davisreinaguerra/Monster_Task/matlab_control/run.png

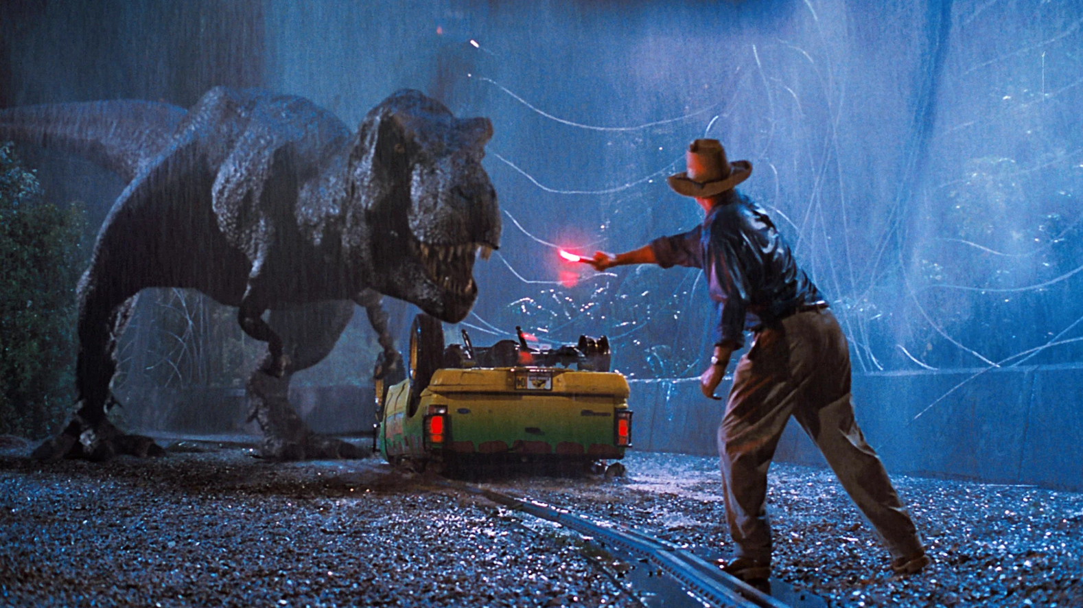
matlab_control/run.png
