davisreinaguerra/Monster_Task/arduino_main/README.md

### Initialization Code

```c++
//______________ Custom Classes_____________________
#include "lick_sensor.h"
#include "solenoid.h"
#include "alignment.h"
#include "IR_sensor.h"

//_______________ Door Servo Setup _________________
#include <Servo.h>
Servo doorServo;
#define door_open_pos 85
#define door_closed_pos 180

// _______________LCD Display_______________________
#include <LiquidCrystal_I2C.h>
LiquidCrystal_I2C lcd(0x27,20,4);

// ____________Variable Initializations_____________
const int flush_volume_delay 2000; // ms
long int delay_between_lick_and_deliver 50;
int current_trial = 0;
unsigned long start_time;
unsigned long lick_time;  
int state;
bool ready_to_begin = false;

  // Session config
long int n_trials;
long int intertrial_interval;
long int enter_time_limit;
long int reward_volume;
long int monster_qm;
long int sound_qm;
long int begin_qm;

//_______________Data Structure____________________
typedef struct {
  // numerical data
  long int trial_duration;
  long int latency_to_enter;
  long int latency_to_trigger;
  long int latency_to_lick;
  long int escape_duration;
  // logical data  
  bool mouse_entered = false;
  bool threat_triggered = false;
  bool port_licked = false;
} monster_session;

monster_session trial[n_trials];

//_______________Pin Assignments_____________________
                                          // D0
                                          // D1
IR_sensor nestIR(2);                      // D2
IR_sensor enterIR(3);                     // D3 ~
IR_sensor threatIR(4);                    // D4
#define door_pin 5                        // D5 ~
solenoid reward_port(6);                  // D6 ~
lick_sensor lick(7);                      // D7
#define sound_trigger_pin 8               // D8 
#define threat_trigger_pin 9              // D9 ~
alignment threat_trigger_alignment(10);   // D10 ~
alignment lick_reward_alignment(11);      // D11 ~
alignment start_alignment(12);            // D12
                                          // D13
```

### Void Setup
```c++
void setup() {
  // Open serial port
  Serial.begin(9600);

  // PinModes
  pinMode(threat_trigger_pin, OUTPUT);
  pinMode(sound_trigger_pin, OUTPUT);
  doorServo.attach(door_pin);

  // Initialize LCD screen
  lcd.init();
  lcd.clear();
  lcd.backlight();

  // Configure Session
  lcd_write(0, 0, "Waiting 4 config...");

  n_trials = read_config();
  intertrial_interval = read_config();
  enter_time_limit = read_config();
  reward_volume = read_config();
  monster_qm = read_config();
  sound_qm = read_config();
  begin_qm = read_config();

  // Report Configuration
  lcd_write_2_lines(0, 0, "n_trials: ", 0, 2, String(n_trials));
  lcd_write_2_lines(0, 0, "intertrial_interval (ms): ", 0, 2, String(intertrial_interval));
  lcd_write_2_lines(0, 0, "enter_time_limit (ms): ", 0, 2, String(enter_time_limit));
  lcd_write_2_lines(0, 0, "reward_volume (ms): ", 0, 2, String(reward_volume));

  switch (monster_qm) {
    case 1: 
      lcd_write(0,0,"Monster: ON");
      break;
    case 0:
      lcd_write(0,0,"Monster: OFF");
      break;
  }

  switch (sound_qm) {
    case 1: 
      lcd_write(0,0,"Sound: ON");
      break;
    case 0:
      lcd_write(0,0,"Sound: OFF");
      break;
  }

  switch (begin_qm) {
    case 1: 
      lcd_write(0,0, "Session begun!");
      break;
    case 0:
      while(1);
  }
  
  start_time = millis();
  state = 0;
}
```

### Void Loop
```c++
void loop() {

  if (current_trial > n_trials) {state = 6;}

  switch (state) {
    
    case 0: // Session Begun

      // Do this
      fast_open();
      
      // Check for state switching events
      if (enterIR.is_broken()) {
        state = 1;
        start_alignment.align_offset();
        Serial.println("State Switch -> Mouse Entered State");
        lcd_write("Mouse Entered");
      }
      if ((millis() - start_time) > enter_time_limit) {
        state = 5;
        Serial.println("State Switch -> Trial Ended State");
        lcd_write("Trial ended");
      }
      
      break; 

    case 1: // Mouse Entered

      // Report this
      trial[current_trial].mouse_entered = true;
      trial[current_trial].latency_to_enter = millis() - start_time;

      // Check for state switching events
      if (threatIR.is_broken()) {
        state = 2;
        Serial.println("State Switch -> Threat Triggered State");
        lcd_write("Threat triggered");
      }
      if (nestIR.is_broken()) {
        state = 5;
        Serial.println("State Switch -> Trial Ended State");
        lcd_write("Trial ended");
      }
      
      break;

    case 2: // Threat Triggered

      // Do this
      threat_trigger_alignment.align_onset();
      digitalWrite(threat_trigger_pin, monster_qm);
      digitalWrite(sound_trigger_pin, sound_qm);
      
      // Report this
      trial[current_trial].threat_triggered = true;
      trial[current_trial].latency_to_trigger = millis() - start_time;

      // Check for state switching events
      if (lick.is_licked()) {
        state = 3;
        lick_reward_alignment.align_onset(); 
        Serial.println("State Switch -> Port Licked State");
        lcd_write("Port Licked");
      }
      if (nestIR.is_broken()) {
        state = 5;
        threat_trigger_alignment.align_offset();
        Serial.println("State Switch -> Trial Ended State");
        lcd_write("Trial ended");
      }
      
      break;

    case 3: // Port_licked
            
      lick_time = millis();
  
      // Report this
      trial[current_trial].port_licked = true;
      trial[current_trial].latency_to_lick = millis() - start_time;

      lick_reward_alignment.align_offset();

      // Wait
      delay(delay_between_lick_and_deliver);      

      // Do this
      reward_port.pulse_valve(solenoid_volume_delay);
      lick_reward_alignment.align_onset();

      state = 4;
      Serial.println("State Switch -> Reward Delivered State");
      lcd_write("Reward Delivered");
      lick_reward_alignment.align_offset();

      break;
    
    case 4: // Reward Delivered

      // Check for state switching events
      if (nestIR.is_broken()) {
        trial[current_trial].escape_duration = millis() - lick_time;
        state = 5;
        threat_trigger_alignment.align_offset();
        Serial.println("State Switch -> Trial Ended State");
        lcd_write("Trial ended");
      }

      break;

    case 5: // Trial_ended
      
      // Close the door
      fast_close();
      
      // Report this
      Serial.println("# Trial has ended");
      trial[current_trial].trial_duration = millis() - start_time;

      // display trial outcomes to serial monitor
      Serial.print("Trial = "); Serial.println(current_trial); // Trial Number

      Serial.print("trial_duration = "); Serial.println(trial[current_trial].trial_duration);
      Serial.print("latency_to_enter = "); Serial.println(trial[current_trial].latency_to_enter);
      Serial.print("latency_to_trigger = "); Serial.println(trial[current_trial].latency_to_trigger);
      Serial.print("latency_to_lick = "); Serial.println(trial[current_trial].latency_to_lick);
      Serial.print("escape_duration = "); Serial.println(trial[current_trial].escape_duration);
      Serial.print("mouse_entered = "); Serial.println(trial[current_trial].mouse_entered);
      Serial.print("threat_triggered = "); Serial.println(trial[current_trial].threat_triggered);
      Serial.print("port_licked = "); Serial.println(trial[current_trial].port_licked);

      // Finalize this trial
      digitalWrite(threat_trigger_pin, LOW);
      digitalWrite(sound_trigger_pin, LOW);

      // Wait for the intertrial interval
      delay(intertrial_interval);

      //Move on to next trial
      current_trial += 1;
      state = 0;
      start_alignment.align_onset();
      Serial.println("State Switch -> Session Begun State");
      start_time = millis();
      break;

    case 6: // Session Complete
      Serial.println("Session Complete!");
      fast_close();
      while(1);
  }  
```

### Function Declarations
```c++
void fast_open() {
  doorServo.write(door_open_pos);
}

void fast_close() {
  doorServo.write(door_closed_pos);
}

void slow_open() {
  for (int pos = door_closed_pos; pos >= door_open_pos; pos -= 1) {
    doorServo.write(pos);             
    delay(20);                       
  }
}

void slow_close() {
  for (int pos = door_open_pos; pos <= door_closed_pos; pos += 1) {
    doorServo.write(pos);              
    delay(20);                      
  }
}

long int read_config() {
  while (!Serial.available()) {}
  return Serial.parseInt();
}

void lcd_write(String message) {
  lcd.clear();
  lcd.setCursor(space, line);
  lcd.print(message);
  delay(2000);
}

void lcd_write_2_lines(int space1, int line1, String message1, int space2, int line2, String message2) {
  lcd.clear();
  lcd.setCursor(space1, line1);
  lcd.print(message1);
  lcd.setCursor(space2, line2);
  lcd.print(message2);
  delay(2000);
}

```
