davisreinaguerra/Monster_Task/hardware/electronics/TRconflictschematic.pdf

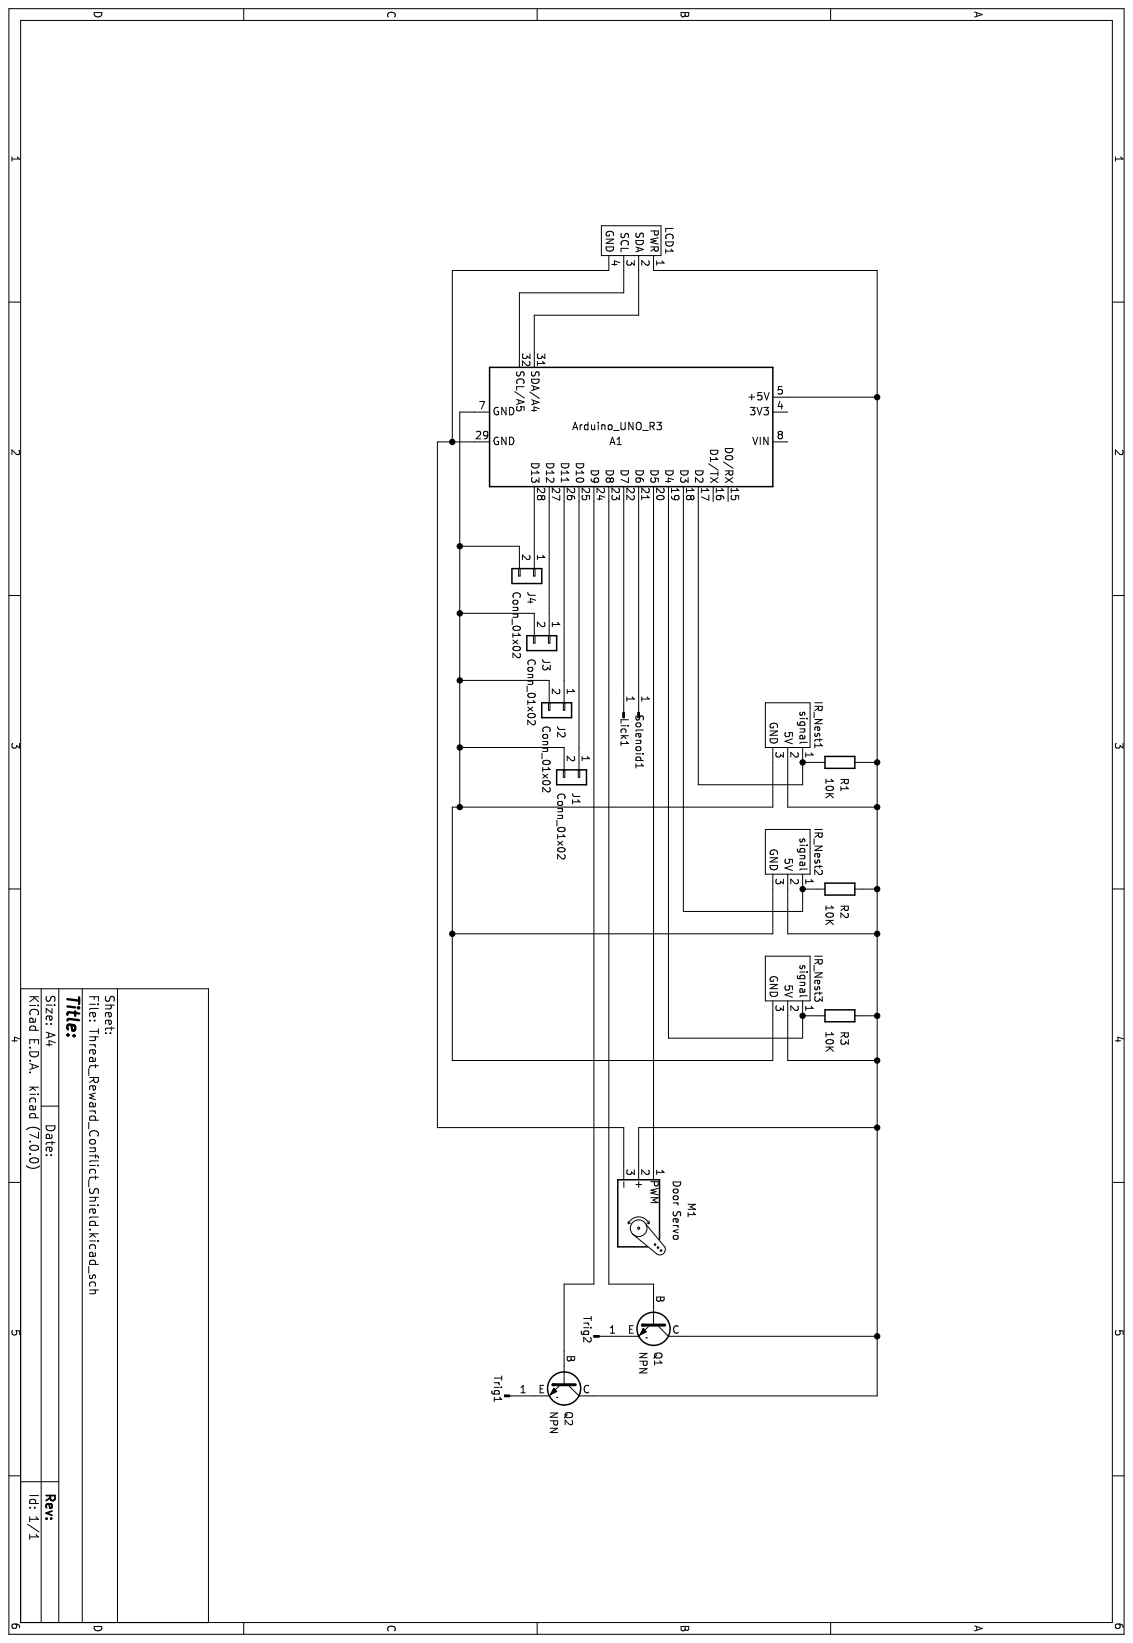
[picture p2: page 1]
