davisreinaguerra/Monster_Task/arduino_main/IR_sensor.h

#ifndef IR_sensor_h
#define IR_sensor_h

#include "Arduino.h"

class IR_sensor {
  public:
    IR_sensor(int pin); // constructor
    bool is_broken();
    bool isnt_broken();
    bool is_rising();
    bool is_falling(); 
  private:
    int _pin;
};

#endif
