davisreinaguerra/Monster_Task/(commit log)

2022-07-25 Create Breakout Boards
2022-07-25 Update and rename materials/Breakout Boards to Step 1: Build the Box
2022-07-25 Create Step 2: Build the Circuit
2022-07-25 Update Step 2: Build the Circuit
2022-07-25 Rename Step 2: Build the Circuit to Step 2: Build the Circuit.md
2022-07-28 Update Step 2: Build the Circuit.md
2023-04-20 Create BOM
